eren61ts/VisionBot/(commit log)

2026-04-27 Unterlagen Zu den Hersteller Daten und Arduino Code hochgeladen
2026-04-27 Ergänzung des readme
    Updated project description and added detailed features, hardware, functionality, setup instructions, and notes.
2026-04-29 Doku zum Projekt in pdf und odt
